debdeep541/Battery_Circuit/Battery_Circuit_Final_BOM.xlsx

Item | Designator(s) | Qty | Value / Part | Footprint | Component Type | Functional Description / Working
1 | C1, C2, C3, C4, C5, C6, C7 | 7 | 0.1µF | C_0402_1005Metric | Capacitor | Decoupling capacitors to filter high-frequency noise near the MCU and IC power pins.
2 | C8 | 1 | 4.7µF | C_0603_1608Metric | Capacitor | Input/Output filtering for the TPS54202DDC buck converter.
3 | C9 | 1 | 10µF | C_0805_2012Metric | Capacitor | Smoothing capacitor for the regulated 3.3V power rail.
4 | C10 | 1 | 22µF | C_0805_2012Metric | Capacitor | Bulk output capacitance for the buck converter to maintain stable voltage under load.
5 | D1 | 1 | SMAJ20A | D_SMA | TVS Diode | 20V Transient Voltage Suppressor. Clamps dangerous voltage spikes to protect the MCU from overvoltage transients.
6 | D2 | 1 | SS14 | D_SMA | Schottky Diode | Provides reverse polarity protection and handles inductive flyback currents from the power path.
7 | D3, D4, D5, D6 | 4 | Green LED | LED_0603_1608Metric | LED | Visual battery capacity indicators mapped to voltage thresholds (25%, 50%, 75%, 100%).
8 | D7 | 1 | Red LED | LED_0603_1608Metric | LED | Emergency fault indicator (Triggers on Overvoltage >17.5V, Undervoltage <15V, or Overtemp >45°C).
9 | FID1, FID2 | 2 | Fiducial | Fiducial_1mm_Mask2mm | Optical Marker | Asymmetrical corner reference markers for the NeoDen YY1 pick-and-place machine camera alignment.
10 | J1 | 1 | 1827685-4 | TE_1827685-4 | Connector | Main high-current battery/power terminal connector.
11 | J2 | 1 | SWD Header | PinHeader_1x04_P2.54mm_Vertical | Connector | 4-pin SWD interface used to program and debug the STM32 via ST-Link.
12 | L1 | 1 | 4.7µH | L_Bourns-SRN4018 | Inductor | Main energy storage inductor for the TPS54202 switching buck converter.
13 | Q1 | 1 | Si2309DS | SOT-23 | MOSFET (P-Channel) | Main power switch. Physically cuts off power to the load during an emergency hardware stop.
14 | Q2 | 1 | BC847 | SOT-23 | BJT (NPN) | Logic-level gate driver controlled by the MCU to pull down and turn Q1 (MOSFET) on/off.
15 | R1, R2, R3, R4, R5 | 5 | 120Ω | R_0402_1005Metric | Resistor | Current limiting resistors configured for higher LED brightness (~10mA draw).
16 | R6, R7, R8, R13 | 4 | 10kΩ | R_0402_1005Metric | Resistor | Pull-up/pull-down resistors for stabilizing logic lines and preventing floating MOSFET gates.
17 | R9 | 1 | 1kΩ | R_0402_1005Metric | Resistor | Base current limiting resistor for the BC847 NPN transistor.
18 | R10 | 1 | 91kΩ | R_0402_1005Metric | Resistor | High-side resistor for the main battery voltage divider (scaling 18V down to 3.3V for ADC sensing).
19 | R11 | 1 | 100kΩ | R_0402_1005Metric | Resistor | Additional voltage scaling or logic line pull-down resistor.
20 | R12 | 1 | 32.4kΩ | R_0402_1005Metric | Resistor | Precision resistor setting the feedback voltage loop for the TPS54202DDC buck converter.
21 | R14 | 1 | 10kΩ | R_0402_1005Metric | Resistor | Top/Bottom leg of the thermistor voltage divider.
22 | SW1 | 1 | SW_Push | SW_SPST_B3U-1000P | Switch | Tactile push button for user interaction (e.g., wake device or check battery level).
23 | TH1 | 1 | 10k NTC | R_0402_1005Metric | Thermistor | Thermal sensor. Resistance drops as heat rises; MCU triggers emergency shutdown if temp exceeds 45°C.
24 | TP1, TP2, TP3, TP4, TP5 | 5 | TestPoint | TestPoint_Pad_3.0x3.0mm | Test Point | Exposed copper pads for multimeter probing and automated QA testing during assembly.
25 | U1 | 1 | TPS54202DDC | SOT-23-6 | Buck Converter | Steps down the high 15.4V-18V battery voltage to a safe, stable 3.3V to power the STM32 MCU.
26 | U2 | 1 | STM32G071GBUxN | Package_DFN_QFN:QFN-28_4x4mm_P0.5mm | Microcontroller | The 28-pin MCU brain. Runs the firmware, polls ADC sensors, and commands Q1 cutoff.
