debdeep541/Battery_Circuit/Battery Circuit.kicad_pcb

## KiCad design Battery Circuit.kicad_pcb (2026-09-16)

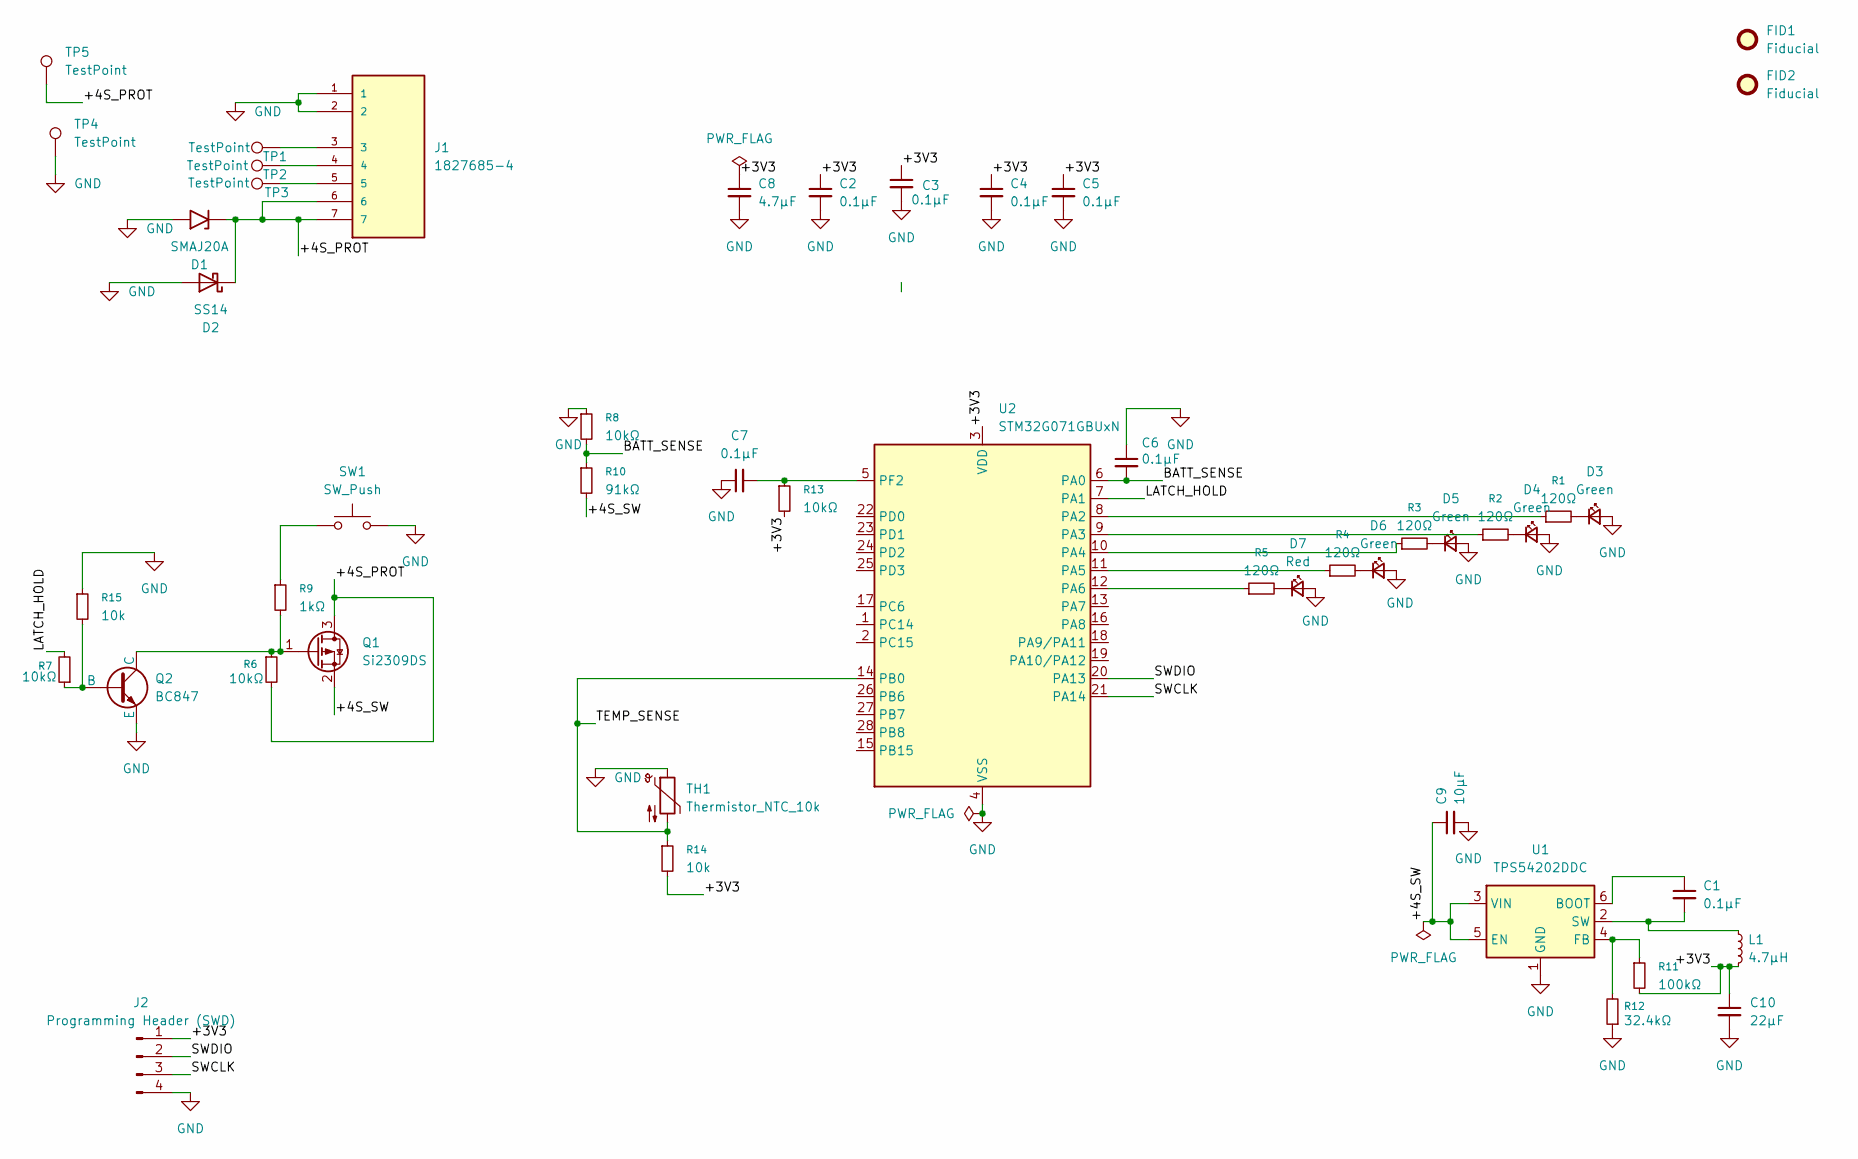
[picture p1: schematic Battery Circuit.kicad_sch]

Parts:
C1, C2, C3, C4, C5, C6, C7: 0.1µF; C_0402_1005Metric
C8: 4.7µF; C_0603_1608Metric
C9: 10µF; C_0805_2012Metric
C10: 22µF; C_0805_2012Metric
D1: SMAJ20A; D_SMA
D2: SS14; D_SMA
D3, D4, D5, D6: Green; LED_0603_1608Metric
D7: Red; LED_0603_1608Metric
FID1, FID2: Fiducial; Fiducial_1mm_Mask2mm
J1: 1827685-4; TE_1827685-4; DigiKey_Part_Number A139165-ND
J2: Programming Header (SWD); PinHeader_1x04_P2.54mm_Vertical
L1: 4.7µH; L_Bourns-SRN4018
Q1: Si2309DS; SOT-23
Q2: BC847; SOT-23
R1, R2, R3, R4, R5: 120Ω; R_0402_1005Metric
R6, R7, R8, R13: 10kΩ; R_0402_1005Metric
R9: 1kΩ; R_0402_1005Metric
R10: 91kΩ; R_0402_1005Metric
R11: 100kΩ; R_0402_1005Metric
R12: 32.4kΩ; R_0402_1005Metric
R14, R15: 10k; R_0402_1005Metric
SW1: SW_Push; SW_SPST_B3U-1000P
TH1: Thermistor_NTC_10k; R_0402_1005Metric
TP1, TP2, TP3, TP4, TP5: TestPoint; TestPoint_Pad_3.0x3.0mm
U1: TPS54202DDC; SOT-23-6
U2: STM32G071GBUxN; QFN-28_4x4mm_P0.5mm

Connections:
/+3V3: C2.1, C3.1, C4.1, C5.1, C8.1, C10.1, J2.1, L1.2, R11.2, R13.2, R14.2, U2.3 (VDD)
/+4S_PROT: D1.1 (A1), D2.1 (K), J1.6, J1.7, Q1.3 (D), R6.2, TP5.1 (1_1)
/+4S_SW: C9.1, Q1.2 (S), R10.2, U1.3 (VIN), U1.5 (EN)
/BATT_SENSE: C6.2, R8.2, R10.1, U2.6 (PA0)
/LATCH_HOLD: R7.2, U2.7 (PA1)
/SWCLK: J2.3, U2.21 (PA14)
/SWDIO: J2.2, U2.20 (PA13)
/TEMP_SENSE: R14.1, TH1.2, U2.14 (PB0)
GND: C2.2, C3.2, C4.2, C5.2, C6.1, C7.1, C8.2, C9.2, C10.2, D1.2 (A2), D2.2 (A), D3.2 (A), D4.2 (A), D5.2 (A), D6.2 (A), D7.2 (A), J1.1, J1.2, J2.4, Q2.3 (E), R8.1, R12.1, R15.1, SW1.2, TH1.1, TP4.1 (1_1), U1.1 (GND), U2.4 (VSS)
unnamed: D3.1 (K), R1.2
unnamed: D4.1 (K), R2.2
unnamed: D5.1 (K), R3.2
unnamed: D6.1 (K), R4.2
unnamed: D7.1 (K), R5.2
unnamed: J1.3, TP1.1 (1_1)
unnamed: J1.4, TP2.1 (1_1)
unnamed: J1.5, TP3.1 (1_1)
unnamed: Q1.1 (G), Q2.1 (C), R6.1, R9.2
unnamed: Q2.2 (B), R7.1, R15.2
unnamed: R9.1, SW1.1
unnamed: C1.1, U1.6 (BOOT)
unnamed: R11.1, R12.2, U1.4 (FB)
unnamed: C1.2, L1.1, U1.2 (SW)
unnamed: R1.1, U2.8 (PA2)
unnamed: R2.1, U2.9 (PA3)
unnamed: R3.1, U2.10 (PA4)
unnamed: R4.1, U2.11 (PA5)
unnamed: R5.1, U2.12 (PA6)
unnamed: C7.2, R13.1, U2.5 (PF2)

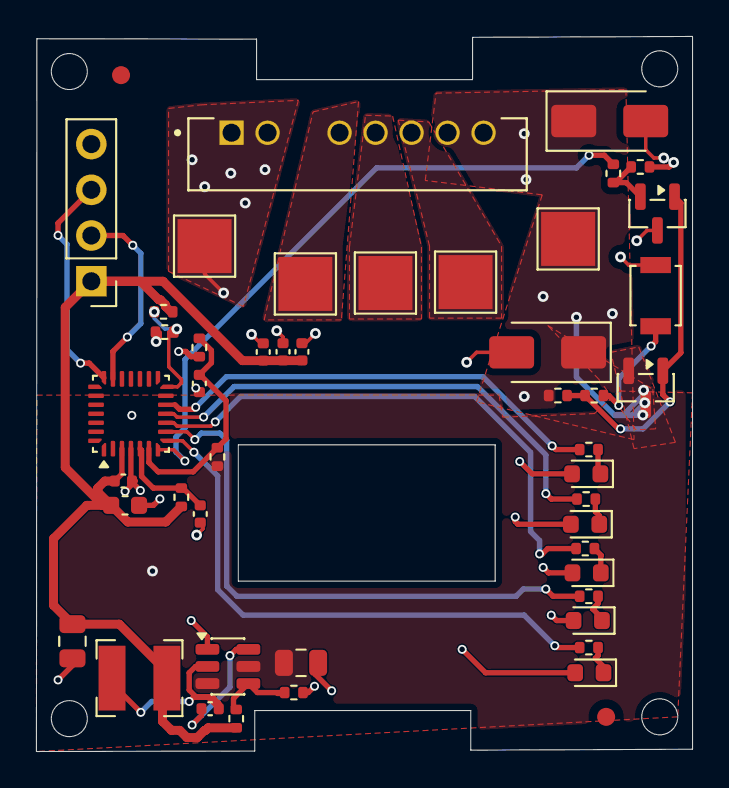
[picture p2: board Battery Circuit.kicad_pcb from above]

Board: 4 copper layers, 36.4 x 39.7 mm, 48 parts (0 on the bottom side), 29 nets.
