debdeep541/Battery_Circuit/Battery_Circuit_Firmware/src/main.c

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
/* Includes ------------------------------------------------------------------*/
#include "main.h"

// --- Safety Thresholds & Configurations ---
#define VOLTAGE_MAX_MV       17500   // 17.5V Overcharge threshold
#define VOLTAGE_MIN_MV       15000   // 15.0V Deep discharge threshold
#define ADC_MAX_MV_RANGE     24000   // Calibrated down from 25404 for standalone VREF
#define TEMP_MAX_45C_ADC     1400    // Calibrated hot threshold (Triggers when value goes ABOVE this)
#define ADC_TIMEOUT_LIMIT    5000    // Rule 6: Timeout counter limit
#define MAX_LIFETIME_LOOPS   0xFFFFFFFF // Rule 6: Ultimate main loop safety cap

ADC_HandleTypeDef hadc1;

void SystemClock_Config(void);
static void MX_GPIO_Init(void);
static void MX_ADC1_Init(void);
void executeEmergencyStop(void);
void updateLedDisplay(uint32_t voltageMv);
uint16_t readADCChannel(uint32_t channel);


/**
 * @brief Executes a physical hardware-level shutdown.
 * Rule 3: Function body < 50 Lines.
 * Rule 7: Hardware stop saves lives. Drops latch pin to physically cut power.
 */
void executeEmergencyStop(void) {
    // Cut main power via MOSFET (PF2) and drop LATCH_HOLD (PA1)
    HAL_GPIO_WritePin(GPIOF, GPIO_PIN_2, GPIO_PIN_RESET); 
    HAL_GPIO_WritePin(GPIOA, GPIO_PIN_1, GPIO_PIN_RESET); 
    
    // Turn ON Red Fault LED (PA6)
    HAL_GPIO_WritePin(GPIOA, GPIO_PIN_6, GPIO_PIN_SET);
    
    // Turn OFF all Green LEDs (PA2-PA5) to signal shutdown
    HAL_GPIO_WritePin(GPIOA, GPIO_PIN_2|GPIO_PIN_3|GPIO_PIN_4|GPIO_PIN_5, GPIO_PIN_RESET);
}

/**
 * @brief Maps battery voltage to the LED array without deep nesting.
 * Rule 3: Function body < 50 Lines.
 * Rule 4: No 3+ nested if-else. Uses flat sequential evaluation instead of else-if.
 */
void updateLedDisplay(uint32_t voltageMv) {
    uint8_t ledsToLight = 0;
    
    // Sequential evaluation ensures 0 layers of nesting
    if (voltageMv >= 15500) { ledsToLight = 1; } 
    if (voltageMv >= 16000) { ledsToLight = 2; } 
    if (voltageMv >= 16500) { ledsToLight = 3; } 
    if (voltageMv >= 17000) { ledsToLight = 4; } 
    
    // Update Pins using flat ternary logic
    HAL_GPIO_WritePin(GPIOA, GPIO_PIN_2, (ledsToLight >= 1) ? GPIO_PIN_SET : GPIO_PIN_RESET);
    HAL_GPIO_WritePin(GPIOA, GPIO_PIN_3, (ledsToLight >= 2) ? GPIO_PIN_SET : GPIO_PIN_RESET);
    HAL_GPIO_WritePin(GPIOA, GPIO_PIN_4, (ledsToLight >= 3) ? GPIO_PIN_SET : GPIO_PIN_RESET);
    HAL_GPIO_WritePin(GPIOA, GPIO_PIN_5, (ledsToLight >= 4) ? GPIO_PIN_SET : GPIO_PIN_RESET);
    
    // Ensure Red LED is OFF and Power Latch is maintained
    HAL_GPIO_WritePin(GPIOA, GPIO_PIN_6, GPIO_PIN_RESET); 
    HAL_GPIO_WritePin(GPIOF, GPIO_PIN_2, GPIO_PIN_SET);
    HAL_GPIO_WritePin(GPIOA, GPIO_PIN_1, GPIO_PIN_SET);
}

/**
 * @brief Reads a specific ADC channel dynamically with 8-sample oversampling.
 * Rule 1: No break/goto (uses readComplete flag).
 * Rule 6: Uses timeoutCounter instead of an infinite while loop.
 */
uint16_t readADCChannel(uint32_t channel) {
    ADC_ChannelConfTypeDef sConfig = {0};
    uint32_t sampleSum = 0;
    
    sConfig.Channel = channel;
    sConfig.Rank = ADC_REGULAR_RANK_1;
    sConfig.SamplingTime = ADC_SAMPLINGTIME_COMMON_1;
    
    HAL_ADC_ConfigChannel(&hadc1, &sConfig);
    
    // Take 8 rapid samples and sum them up to filter noise spikes
    for (uint8_t i = 0; i < 8; i++) {
        volatile uint16_t timeoutCounter = 0;
        volatile uint8_t readComplete = 0; 
        uint16_t singleReading = 0;

        HAL_ADC_Start(&hadc1);
        
        while ((readComplete == 0) && (timeoutCounter < ADC_TIMEOUT_LIMIT)) {
            if (HAL_ADC_PollForConversion(&hadc1, 1) == HAL_OK) {
                singleReading = HAL_ADC_GetValue(&hadc1);
                readComplete = 1; 
            } 
            if (readComplete == 0) {
                timeoutCounter++;
            }
        }
        HAL_ADC_Stop(&hadc1);
        sampleSum += singleReading;
    }
    
    // Return the integer average (sum / 8)
    return (uint16_t)(sampleSum / 8);
}

/**
 * @brief  The application entry point.
 * Rule 6: Removes while(1). Replaced with evaluated run state and loop limits.
 */
int main(void)
{
  // 'volatile' ensures compiler respects the safety counter and run state
  volatile uint8_t systemRunning = 1;
  volatile uint32_t mainSafetyCounter = 0;

  HAL_Init();
  SystemClock_Config();
  MX_GPIO_Init();
  MX_ADC1_Init();

  // Rule 7: Assert power hold immediately on startup
  HAL_GPIO_WritePin(GPIOF, GPIO_PIN_2, GPIO_PIN_SET); 
  HAL_GPIO_WritePin(GPIOA, GPIO_PIN_1, GPIO_PIN_SET); 

  // Allow standalone buck regulator and ADC to stabilize before first reading
  HAL_Delay(250); 

  // Rule 6: Strict indefinite loop protection via counter
  while ((systemRunning == 1) && (mainSafetyCounter < MAX_LIFETIME_LOOPS))
  {
    uint16_t rawBatt = readADCChannel(ADC_CHANNEL_0);
    uint16_t rawTemp = readADCChannel(ADC_CHANNEL_8); 
    uint32_t currentVoltageMv = ((uint32_t)rawBatt * ADC_MAX_MV_RANGE) / 4095; 
    uint8_t faultDetected = 0;
    
    // Sequential State Evaluation (Rule 4)
    if (currentVoltageMv > VOLTAGE_MAX_MV) { faultDetected = 1; }
    if (currentVoltageMv < VOLTAGE_MIN_MV) { faultDetected = 1; }
    if (rawTemp > TEMP_MAX_45C_ADC)        { faultDetected = 1; } // Re-enabled and corrected to trigger on heat increase
    
    if (faultDetected == 1) {
        executeEmergencyStop();
        systemRunning = 0; // Exits loop cleanly without Rule 1 "break" violation
    }
    if (faultDetected == 0) {
        updateLedDisplay(currentVoltageMv);
    }
    
    mainSafetyCounter++;
    HAL_Delay(100); 
  }

  // If system exits loop bounds, force hardware halt
  executeEmergencyStop();
  
  // Terminal safety sink to prevent uncontrolled execution post-halt
  volatile uint16_t terminalHalt = 0;
  while(terminalHalt < 1000) { terminalHalt++; }
}

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
