debdeep541/Battery_Circuit/(commit log)

2026-08-31 Initial commit: Completed Battery Circuit PCB layout and routing
    [Battery Circuit.kicad_pcb, Battery Circuit.kicad_sch]
2026-08-31 Fixed voltage divider: Updated R12 to 32.4k to ensure safe 3.3V output
    [Battery Circuit.kicad_sch]
2026-08-31 Fixed the warning
    [Battery Circuit.kicad_pcb]
2026-09-01 Finalize 4-layer PCB layout: implement 20A top/bottom copper pours, add via stitching, addition of thermistor and clear all DRC violations.
    [Battery Circuit.kicad_pcb, Battery Circuit.kicad_sch]
2026-09-01 feat(system): implement BMS firmware
    [Battery Circuit.kicad_pcb, Battery Circuit.kicad_sch]
2026-09-01 feat(system): GERBER File & BOM with STM32G071GBU6N MCU
    [Battery Circuit-B_Cu.gbl, Battery Circuit-B_Mask.gbs, Battery Circuit-B_Paste.gbp, Battery Circuit-B_Silkscreen.gbo, Battery Circuit-Edge_Cuts.gm1, Battery Circuit-F_Cu.gtl, Battery Circuit-F_Mask.gts, Battery Circuit-F_Paste.gtp]
2026-09-16 feat/fix: Calibrate ADC scaling, adjust thermal noise floor, and validate safety lockout
    ADC scaling updated to 25404 to match physical voltage dividers. Thermal noise floor lowered to 800. Validated executeEmergencyStop() permanent lockout on 15.0V deep-discharge sweep.
    [main.c]
2026-09-16 Update hardware schematic to Rev 1.1 (fixed MOSFET/drain)
    [main.c]
